tymek22/Clock/Schematic and PCB/Clock.brd

## EAGLE design Schematic and PCB/Clock.brd (2019-08-10)

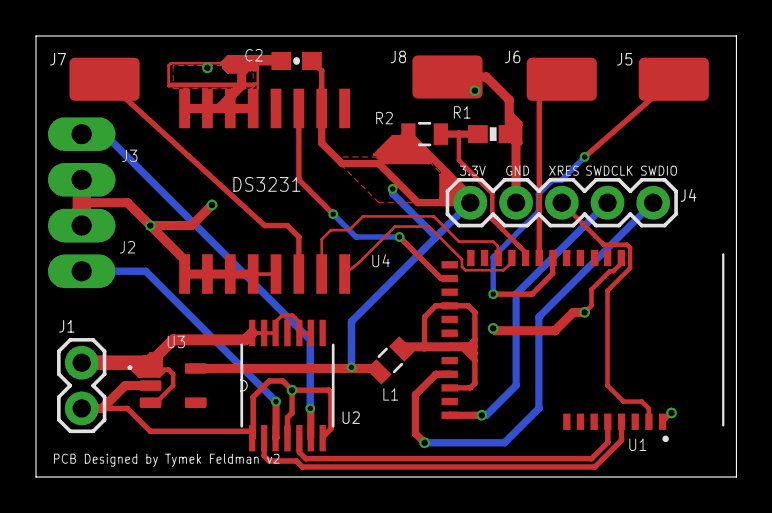
[picture p9: board Clock.brd from above]

Board: 2 copper layers, 38.9 x 24.5 mm, 16 parts (0 on the bottom side), 18 nets.

Parts:
C2: 100nF; 0603-CAP
J1: 5V In; 1X02
J2: LedStripHour; 1X02_LONGPADS
J3: LedStripMinute; 1X02_LONGPADS
J4: 1X05
J5: PIR; LUXEON-PAD
J6: TX; LUXEON-PAD
J7: Vbat; LUXEON-PAD
J8: GND; LUXEON-PAD
L1: 330Ω 100MHz; 0805
R1: 10k; 0603-RES
R2: LDR; 0805
U1: CYBLE-224110-00; CYPRESS_CYBLE-224110-00
U2: SN74AHCT125PW; SOP65P640X120-14N
U3: TLV73333PDBVT; SOT95P280X145-5N
U$1: DS3231; SO16W

Connections:
3.3V: C2.1, J4.5, L1.2, R2.2, U3.5, U$1.2
5V: J1.2, U2.9, U2.10, U2.12, U2.13, U2.14, U3.1, U3.3
GND: C2.2, J1.1, J2.1, J3.1, J4.4, J8.P$1, R1.1, U1.1, U1.32, U2.1, U2.4, U2.7, U3.2, U$1.5, U$1.6, U$1.7, U$1.8, U$1.9, U$1.10, U$1.11, U$1.12, U$1.13
HOUR: U1.4, U2.2
HOURTRACE: J2.2, U2.3
LDR: R1.2, R2.1, U1.25
MINUTE: U1.5, U2.5
MINUTETRACE: J3.2, U2.6
unnamed: J7.P$1, U$1.14
unnamed: L1.1, U1.11, U1.14, U1.17
PIR: J5.P$1, U1.27
SCL: U1.24, U$1.16
SDA: U1.23, U$1.15
SQW: U1.19, U$1.3
SWDCLK: J4.2, U1.9
SWDIO: J4.1, U1.12
TX: J6.P$1, U1.26
XRES: J4.3, U1.2
