tymek22/Clock/(notices)

Notices in the files:
Schematic and PCB/Clock.brd:
Copyright © 2019
parts and their libraries:
SparkFun-Capacitors: Licensing: Creative Commons ShareAlike 4.0 International - https://creativecommons.org/licenses/by-sa/4.0
